pfkellogg/fm1-bonus-box/schematics/fm1_control_box_layout.pdf

## FM-1 Control Box (v2) — Layout / Assembly Diagram

Top-down view of enclosure: pedal jack, button, SING button (left panel), mic module (behind a front-panel hole), ESP32-S3 (center), MIDI out jack (right panel), encoder + round TFT (front panel)

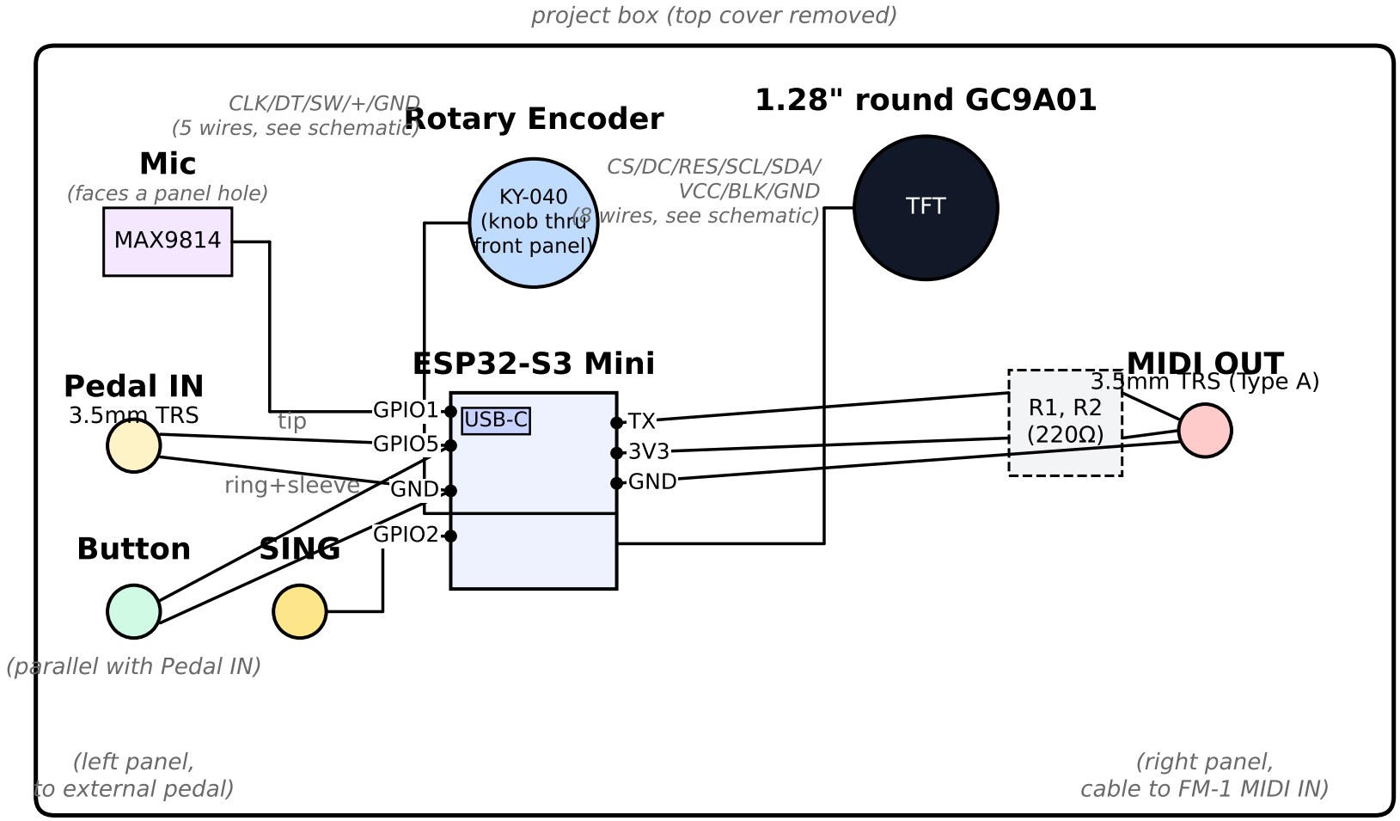
[picture p3: figure]
project box (top cover removed); ESP32-S3 Mini; USB-C; GPIO5; GND; TX 3V3 GND; Pedal IN; 3.5mm TRS; (left panel, to external pedal); Button; (parallel with Pedal IN); MIDI OUT 3.5mm TRS (Type A); (right panel, cable to FM-1 MIDI IN); tip; ring+sleeve; MAX9814; Mic; (faces a panel hole); SING; GPIO1; GPIO2; Rotary Encoder; KY-040 (knob thru front panel); CLK/DT/SW/+/GND (5 wires, see schematic); TFT; 1.28" round GC9A01; CS/DC/RES/SCL/SDA/ VCC/BLK/GND (8 wires, see schematic)

Notes:
- Resistors R1/R2 can live on a small offcut of perfboard, or be soldered directly in-line on the wire runs -- exact placement isn't critical
- See the schematic for the electrical connections (which wire goes through which resistor, which pin is which) -- this diagram is for physical placement only
- Button and Pedal IN jack are wired in parallel to the same GPIO5/GND nodes -- either one alone triggers sustain, so the pedal can be left unplugged
- Encoder knob and TFT window both need cutouts in the front panel -- mock up the panel layout before drilling, this diagram isn't to physical scale
- Leave slack on the USB-C cable path -- the board still needs to be reachable for re-flashing
- v1's pitch-strip input was dropped in this rebuild (see project README History) -- no strip or its wiring here
