pfkellogg/fm1-bonus-box/(commit log)

2026-09-22 Rename project to FM-1 Bonus Box: v2 ESP32-S3 control box
    Adds v2: ESP32-S3 Mini rebuild with rotary encoder preset browsing
    (velocity-accelerated, live MIDI Program Change), a 1.28" round GC9A01
    color TFT with category-colored UI, two switchable bank sources
    (FACTORY embedded in flash / CUSTOM in LittleFS), and a WiFi upload
    mode to load a CUSTOM soundbank from a phone/laptop browser -- no
    computer software needed after the box itself is flashed. Built
    because the FM-1 never transmits its voice data back over MIDI, so
    there's no way to read a better existing soundbank off the device;
    this is the standalone workaround, documented in the README's
    'Different FM-1 units, different soundbanks' s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
    [fm1_control_box.ino, generate_fm1_control_box_schematic.py]
2026-09-22 Add genuine Yamaha DX7 ROM1A/1B/2A/2B factory banks
    Alternative to the FM-1's own recovered factory set (which is mostly
    substitute DX7-community patches, only 40/128 genuine Yamaha) -- these
    are the actual original Yamaha ROM cartridges, downloaded from
    yamahablackboxes.com/patches/dx7/factory/ (same source used by
    KingParamount's own get_dx7_factory.sh and MiniDexed's getsysex.sh).
    Also includes rom1a_piano_first.syx, a one-off reorder of ROM1A with
    genuine PIANO 1 (voice #8) moved to slot 1, so it's still the FM-1's
    boot sound after switching to this set.
    Not openly licensed unlike the rest of reference/ -- Yamaha's original
    factory data, long-circulating in the synth community but neve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
2026-09-22 Note current physical FM-1 state in README
    Tracked by hand since the device can't be read back over MIDI. As of
    now: genuine Yamaha ROM1A/1B/2A/2B (piano-first), after a round trip
    through the recovered-factory set and Bo Tomlyn's Top 40 + Wedding
    Band earlier today.
2026-09-23 Remove all bundled soundbanks; add WiFi soundbank page with drag-and-drop
    No voice data ships in the repo or firmware anymore: the FM-1 factory set,
    Yamaha ROM/VRC, and Bo Tomlyn banks aren't openly licensed. .syx files are
    now gitignored.
    Control box:
    - Holds one 128-voice bank in LittleFS, empty until you load one.
    - WiFi mode page: find .syx files on the phone, load a bank into A-D,
    multi-select drag-and-drop reorder across all 128 slots, save to box,
    and send complete banks to the FM-1 with per-bank knob prompts.
    - Tap toggles LIVE/SILENT browse; Assign now also updates the box's bank.
    - Display color is per bank A-D (slot categories only applied to the
    factory set).
    CLI reads yo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
2026-09-23 Add sing on key mode: mic pitch detection, song upload, DOO reference voice
    - SING button (GPIO2) toggles sing mode; MAX9814 module's onboard mic on
    GPIO1, sampled at 16 kHz by the continuous ADC with YIN pitch detection
    on core 0 (pitch_detector.cpp).
    - Box plays each target note on the FM-1, stops, then listens; live cents
    chart, sung note/octave/frequency, EASY/MEDIUM/EXPERT tolerances, and
    auto-advance on a hit. SONG, DRILL (distinct pitches) and FREE lists.
    - Web page: upload .kar/.mid, auto-pick the melody part, transpose, lyrics;
    insert the project's own CC0 DOO VOICE patch (tools/doo_voice.py).
    - Regular screen shows REGULAR mode and voices loaded per bank.
    - TFT on hardwar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
    [fm1_control_box.ino, generate_fm1_control_box_schematic.py, pitch_detector.cpp, pitch_detector.h, sing_mode.ino, web_page.h]
2026-09-28 Add song playback: play a karaoke song's vocal track on the FM-1
    The web page now sends each vocal note's timing along with the song
    (optional "FM1P" section in song.bin: note, step, start ms, duration ms,
    built from the file's tempo map and note-offs, intro skipped). The box
    can play it in time in the "doo" reference voice:
    - Sing mode gets a PLAY list (SONG -> PLAY -> DRILL -> FREE): plays the
    vocal track with lyrics; knob tap pauses/plays, turning jumps to a note.
    - Web page gets Play / Stop buttons (POST /play, /stop), which switch to
    the reference voice and restore the browsed preset afterward.
    - The player never forwards sustain and sends CC64 off on start, so a
    held pedal can't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
    [fm1_control_box.ino, sing_mode.ino, web_page.h]
2026-09-28 Add Minilab3-style pads to the web page, pitch stepping, lyric screen
    - Web page: the Play/Stop buttons become a row of 8 pads laid out like
    an Arturia Minilab3's. Pad 1 plays the song's vocal track (restarts if
    tapped again), pad 2 stops, pad 3 plays the next pitch of the song for
    1s (repeated same-pitch notes counted once, wraps at the end), pads 4-8
    unused. Pad 1 glows while playing with the current note and lyric
    underneath; "How the pads work" explains them.
    - Box: POST /step (play next pitch, returns it as JSON) and GET
    /playstate (what's playing, for the page).
    - Round screen: in WiFi mode, while pad 1 plays or for 4s after a pad 3
    tap, shows the current lyric large with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
2026-09-28 Add pad 4: replay the current pitch
    Pad 4 on the web page replays the current pitch for 1s: the one pad 3
    last played (the first pitch if none yet), or, while the song is
    playing, the one playing now; the song stops there and pad 3 carries on
    from it. Box side: POST /step?again=1, songStepReplay(); stepping now
    goes through a shared songStepPlay(pos). The lyric screen covers it too.
    Page tested in Chrome against the Python stand-in driving a real FM-1
    (pad 3 twice, then pad 4 replays E4 "sa"). Firmware compiles for esp32s3.
2026-09-28 Fix schematic: 3V3 and GND drops no longer drawn on the same wire
    Each part's power and ground drops were drawn straight down from the
    same pin-end x, so 3V3 and GND ran on top of each other (ESP32 3V3/GND,
    encoder +/GND, TFT VCC/BLK/GND) and read as a 3V3-to-GND short. The
    connections in the generator were always right; only the drawing was
    wrong. Now the ESP32 taps 3V3 and GND on separate columns, and the
    encoder/TFT share one 3V3 column and one GND column, with junction dots
    only at real connections.
    Also: R2's label moved below its resistor so it no longer overlaps R1,
    and the SING note lists the PLAY list (SONG/PLAY/DRILL/FREE).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
    [generate_fm1_control_box_schematic.py]
2026-09-29 Add USB keyboard in: USB MIDI host on the box's USB-C port
    A class-compliant USB MIDI keyboard (e.g. an M-Audio Keystation, which has
    no 5-pin MIDI OUT) now plugs straight into the box and plays the FM-1 through
    the box's TRS MIDI OUT, no computer needed. usb_midi_host.cpp runs ESP-IDF's
    USB host library (up to 4 MIDI devices, hubs supported); the main loop
    forwards cable-0 channel messages remapped to MIDI_CHANNEL, merged with the
    box's own MIDI. Holding the knob at power-on skips host mode for flashing.
    README also flags that the FM-1 may not accept bank SysEx on its TRS MIDI IN
    (a send through a 5-pin interface failed today where USB worked), which
    affects Assign/Send. Compiles (85% flas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
    [fm1_control_box.ino]
2026-10-01 Add fm1_usb_bridge: bare-bones ESP32-S3 USB host, keyboard -> FM-1 over USB
    A separate tiny sketch for playing the FM-1 from a USB-only keyboard (e.g.
    M-Audio Keystation) with no tablet, computer or MIDI cable: both plug into a
    powered USB hub on the ESP32-S3's USB-C port, and every MIDI device gets the
    channel messages every other one plays (cable 0, remapped to channel 1).
    Adds USB-MIDI OUT transfers to the host code from fm1_control_box. Onboard
    RGB LED shows status. Compiles (26% flash / 7% RAM); untested on hardware.
2026-10-02 Add four original FM-1 patches: flute, Abbey brass, Abbey strings, oboe
    Written from scratch for this project and released CC0, like doo_voice.py:
    WENDY FLUT (Moog flute in the Switched-On Bach style), ABBEY BRSS (bright
    60s ensemble synth brass), ABBEY STRS (warm bowed string ensemble) and OBOE.
    Each script prints a 128-byte packed DX7 voice. The flute, brass and strings
    are loaded on the FM-1 and confirmed playing; the oboe hasn't been auditioned.
